PravinduG/sky130_op_amp/README.md

# sky130_ef_ip__template 

Designed by Pravindu Goonetilleke and Nilakna Warushavithana for the IEEE CASS–CEDA Analog IC Design Contest.

- [Documentation](docs/sky130_ef_ip__template.md)
- Characterization
  - [CACE](docs/sky130_op_amp_rcx.md)
  - [schematic](docs/sky130_op_amp_schematic.svg)
  - [layout](docs/sky130_op_amp_b.png)

## License and Information

[The Apache License, version 2.0](https://www.apache.org/licenses/LICENSE-2.0.txt).
