PravinduG/sky130_op_amp/documentation/OPAMP_REPORT.pdf

# Low-Power Single-Ended Operational Amplifier Design Using Sky130 PDK

Analog IC Student Design Contest ’25

1

st Nilakna Warushavithana
Dept. of Electronic and Telecommunication Engineering University of Moratuwa
Katubedda, Sri Lanka
nilaknawarushavithana@gmail.com

1

st Pravindu Goonetilleke
Dept. of Electronic and Telecommunication Engineering University of Moratuwa
Katubedda, Sri Lanka
pravindugoonetilleke@gmail.com

Abstract—This paper presents the design and implementation of a low-power, single-ended operational amplifier using the SkyWater 130 nm CMOS process design kit (SKY130 PDK). The amplifier is designed to function as a non-inverting unity-gain buffer for low-frequency analog signals in the 1-10 kHz range, operating with a supply voltage between 1.7 V and 1.9 V. The design targets a DC gain exceeding 60 dB, a gain-bandwidth product greater than 1 MHz, and phase margin above 60 degrees while maintaining quiescent current consumption below 100 . Complete schematic and post-layout simulations including DC, AC, transient, corner, and Monte Carlo analyses are presented. The final layout fits within the 140 µm × 80 µm area constraint with careful attention to matching and parasitic-aware design techniques.
Index Terms—operational amplifier, low-power, SKY130 PDK, analog IC design, unity-gain buffer, CMOS
I. INTRODUCTION

Low-power operational amplifiers are fundamental building blocks in modern analog and mixed-signal integrated circuits, finding applications in sensor interfaces, signal conditioning, data acquisition systems, and biomedical electronics. Hence, low-voltage, low-power operational amplifier designs are important.
This work presents the complete design flow of a single-ended operational amplifier implemented in the open-source SkyWater 130 nm CMOS process, from architecture selection through post-layout verification. The design targets operation as a unity-gain buffer for low-frequency signals while meeting specified power and area constraints.
The design methodology follows initial hand calculations, schematic-level optimization, extensive simulation verification, careful layout with matching techniques, and comprehensive post-layout validation.

II. DESIGN SPECIFICATIONS AND REQUIREMENTS

The target specifications for the operational amplifier design, as provided by the contest organizers, are listed in Table I.
Interface and power constraints were specified to include one analog supply (VDD), one ground (VSS), differential

TABLE I
TARGET DESIGN SPECIFICATIONS
Parameter | Specification
Technology Supply Voltage (VDD) Input Common-Mode Range Output Load (CL) Temperature Range Input Signal Amplitude Signal Frequency DC Gain (ADC ) Gain-Bandwidth Product (GBW) Phase Margin (PM) Quiescent Current Input Offset Voltage Slew Rate (SR) Disable Current Layout Area | 130 nm CMOS (SKY130) 1.7 - 1.9 V VDD/2 ± 0.2 V 25pF (capacitive) 20 - 50°C < 0.4 Vpp 1 - 10 kHz ≥ 60 dB ≥ 1 MHz > 60 < 100µA < 3 mV > 1 V/µs < 2 nA ≤ 140µm × 80µm

inputs (Vp, Vn), single-ended output (Vout), bias current input (Ibias = 5µA), and digital enable signal (EN). Disable mode should limit the supply current to 2 nA and output node current to 1nA.

III. CIRCUIT ARCHITECTURE AND DESIGN

A. Topology Selection
A two-stage operational amplifier topology was selected for this design because it allows a moderate gain-bandwidth product, an area-efficient layout because of only two stages, low power consumption with proper biasing, and stabile frequency response due to Miller compensation.
The first stage is a differential pair with PMOS current mirror active load providing high gain, while the second stage is a common-source amplifier providing additional gain and low output impedance. Miller compensation capacitor connects the output to the input of the second stage to ensure stability.
B. First Stage Design
The input differential pair employs NMOS transistors (M1-M2) to maximize input common-mode range around VDD/2.

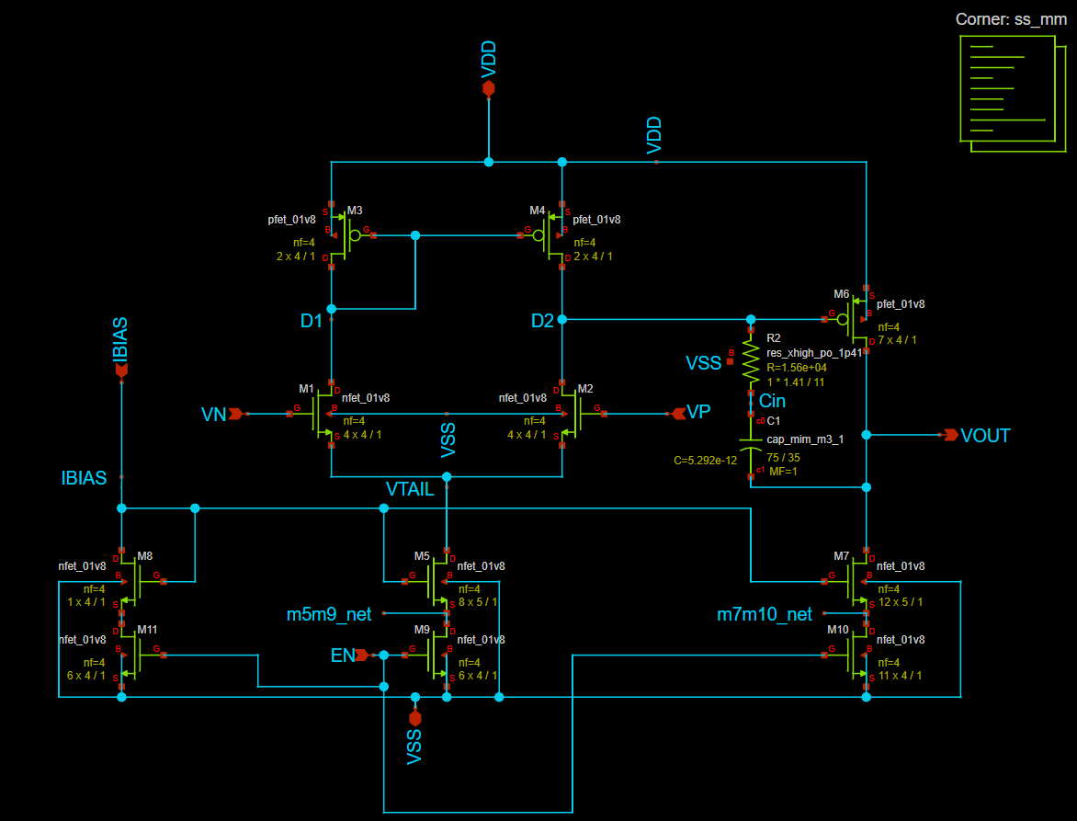
[picture p3: figure]

Fig. 1. Schematic of the design

The active load consists of a PMOS current mirror (M3-M4) providing high differential gain. The tail current source (M5) is biased from the mirrored Ibias current and switched (M9) by the enable signal.
Design parameters:
- Input transistor width: W1 = W2 = 16 µm
- Input transistor length: L1 = L2 = 1 µm
- Active load transistor width: W3 = W4 = 8 µm
- Active load transistor length: L3 = L4 = 1 µm
- Tail current source transistor width: W5 = 40 µm
- Tail current source transistor length: L5 = 1 µm
C. Second Stage Design

The output stage uses a common-source PMOS amplifier (M6) with NMOS current source load (M7), switched by NMOS (M10) by the enable signal. This stage provides additional voltage gain and drives the 25pF output load. Design parameters:

- Output transistor width: W6 = 28 µm
- Output transistor length: L6 = 1 µm
- Current source transistor width: W7 = 60 µm
- Current source transistor length: L7 = 1 µm
D. Frequency Compensation

Miller compensation is implemented using a capacitor C1 connected between the output and the input of the second stage. A resistor R1 in series with C1 eliminates the righthalf-plane zero created by Miller compensation.
Design parameters:
- Compensation capacitor: C1 = 5.292 pF
- Nulling resistor: R1 = 15.6 kΩ
- Unity-gain frequency: fu ≈ 10 MHz
E. Bias Circuit

The external 5 µA bias current is mirrored through a cascode current mirror structure (M8, M5, M7)to generate all internal bias currents. Current ratios are set to achieve desired bias levels while maintaining the total quiescent current below 100 µA.
Design parameters:
- Mirroring transistor width: W8 = 4 µm
- Mirroring transistor length: L8 = 1 µm
F. Enable/Disable Functionality

The enable signal controls current supply in the circuit and limits the supply current to 2 nA and output node current to 1nA in disable mode. The Enable signal is switched via transistors at each stage (M9 and M10) and bias (M11). Design parameters:
- Switching transistor (Stage 1) width: W9 = 24 µm
- Switching transistor (Stage 1) length: L9 = 1 µm
- Switching transistor (Stage 2) width: W10 = 44 µm
- Switching transistor (Stage 2) length: L10 = 1 µm
- Switching transistor (Bias) width: W11 = 24 µm
- Switching transistor (Bias) length: L11 = 1 µm

IV. SCHEMATIC-LEVEL SIMULATION RESULTS

A. DC Analysis

DC analysis was performed at nominal conditions (VDD = 1.8 V, T = 27°C, TT corner) to verify proper biasing of all transistors. All MOSFETs operate in saturation region with adequate overdrive voltages.
Key operating point results:
- Total quiescent current: IQ = 113 µA (enabled), 138 pA (disabled)
- Input common-mode voltage: VCM = 0.9 V
The following parameters were obtained with the op-amp configured as a unity gain non-inverting buffer:
- Input Offset voltage: VIN,OF F SET ≈ 0 mV
- DC Operating point: VOUT ,DC ≈ 0 mV

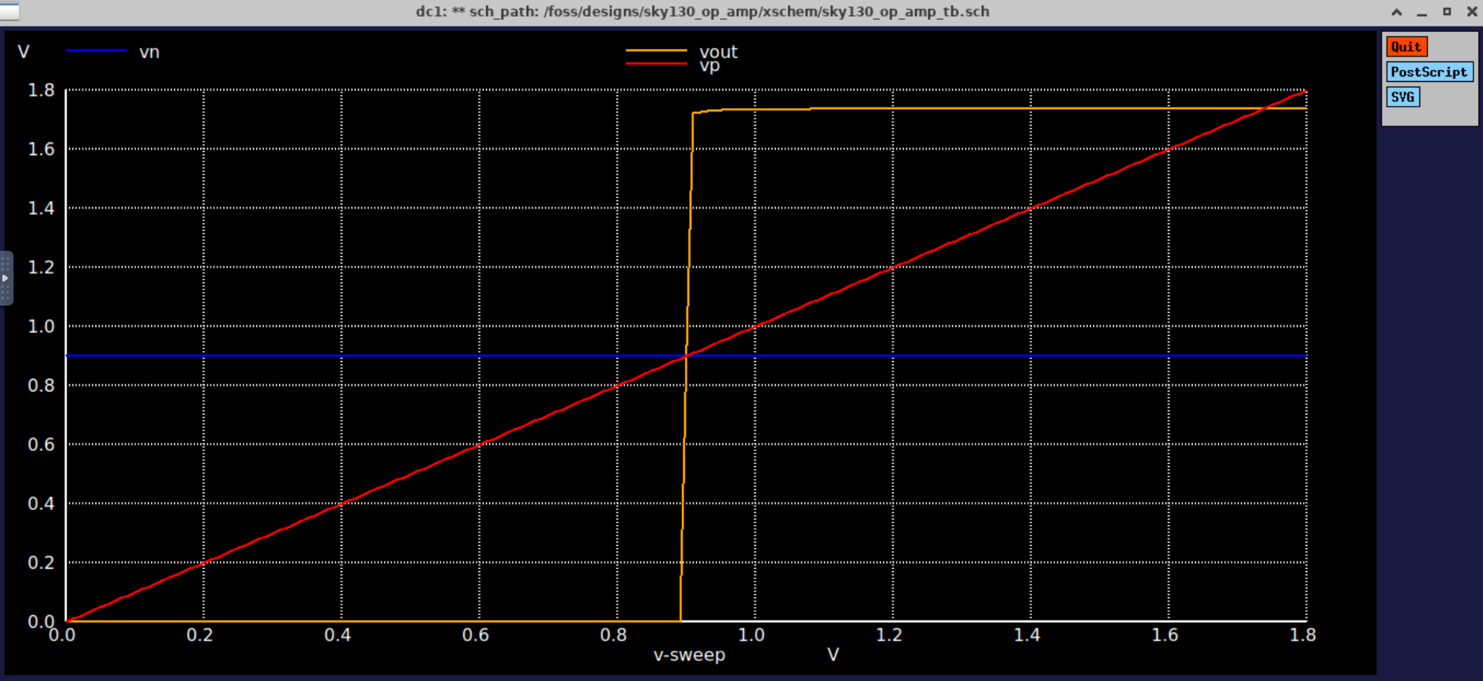
[picture p4: figure]

Fig. 2. DC operating point graph at TT corner.

Fig. 3. Input offset and DC operating point

B. DC Gain

DC sweep analysis determined the DC gain. Results:
- Open-loop DC gain: ADC ≈ 72.38 dB
C. AC/Frequency Analysis

Small-signal AC analysis was performed in open-loop configuration to extract frequency-domain characteristics.

TABLE II
AC ANALYSIS RESULTS AT NOMINAL CONDITIONS (TT CORNER)
Parameter | Result | Spec
DC Gain GBW Phase Margin Gain Margin | 72.38 dB 12.234 MHz 98° > 20dB | ≥ 60 dB ≥ 1 MHz > 60° -

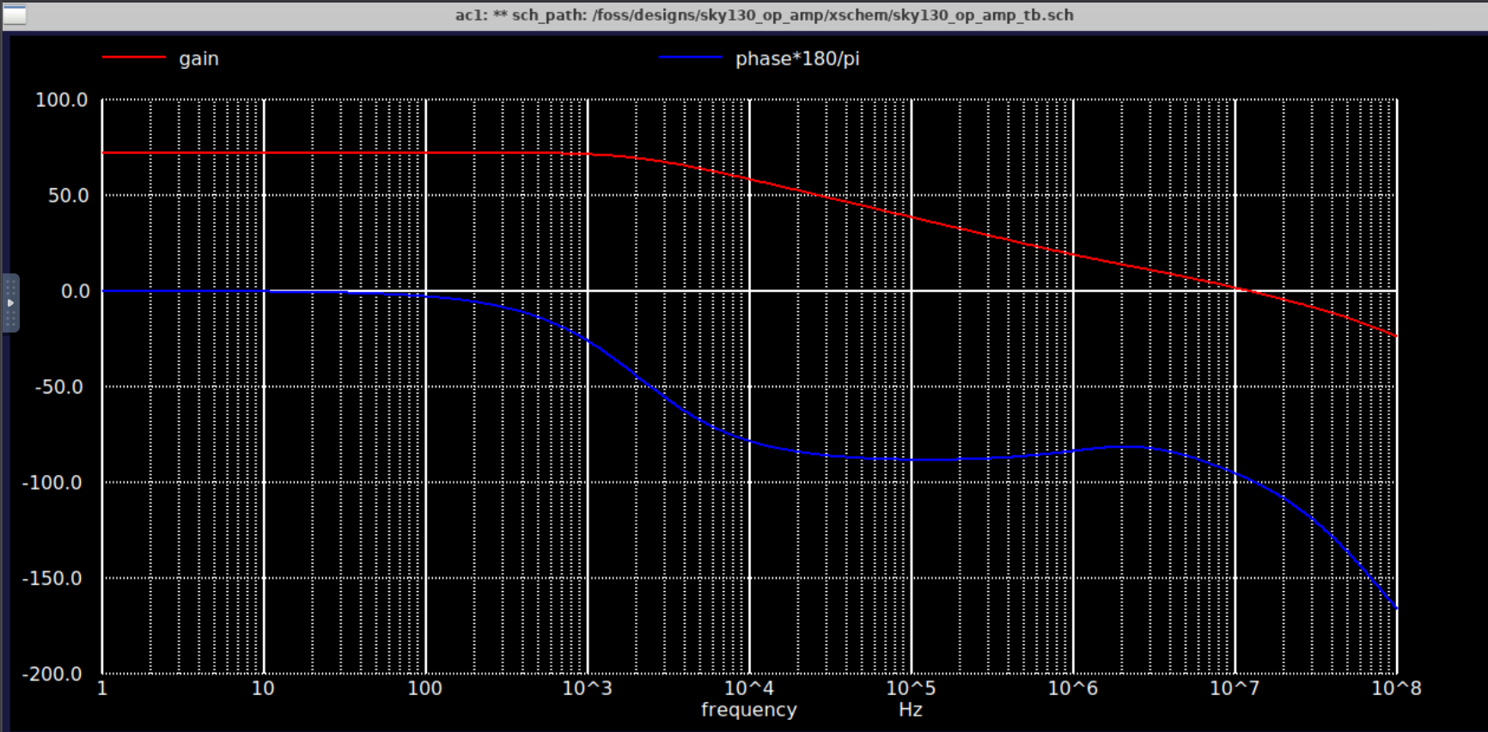
[picture p5: figure]

Fig. 4. AC magnitude and phase plot at TT corner.

D. Transient Analysis

Transient simulations verified time-domain performance.
- Output voltage swing: 0 V to 1.7 V

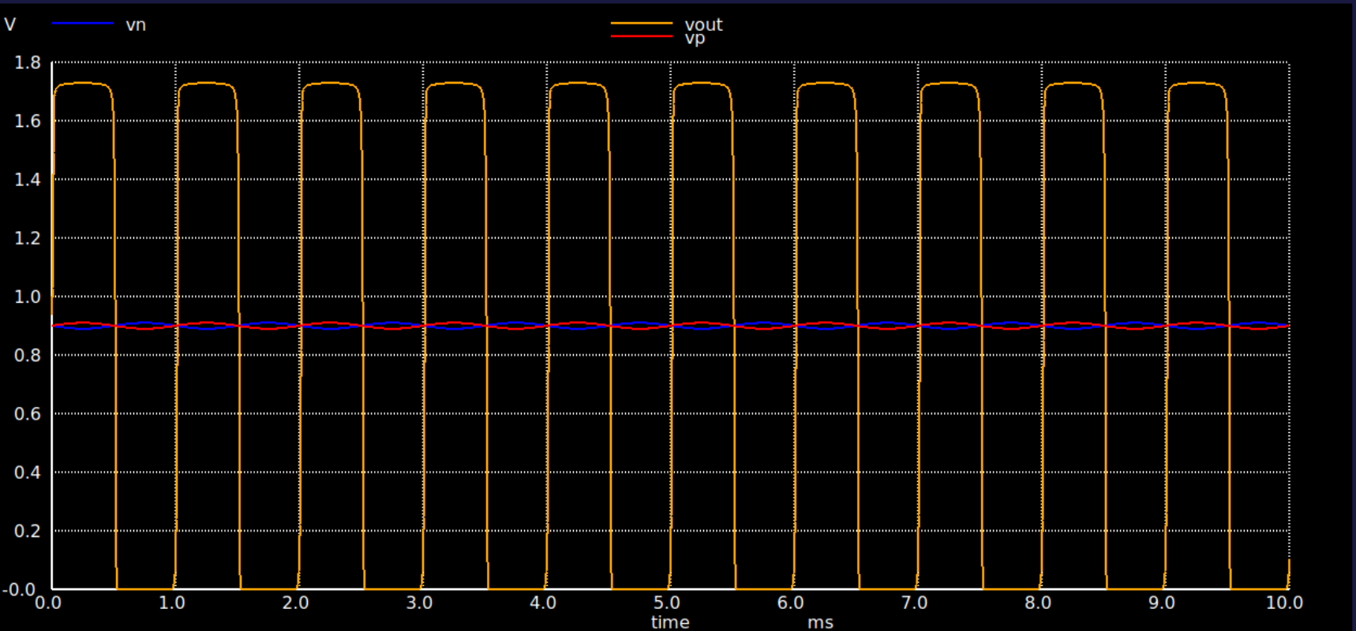
[picture p6: figure]

Fig. 5. Transient output response 0 V to 1.7 V.

- Sinusoidal Input 10µV

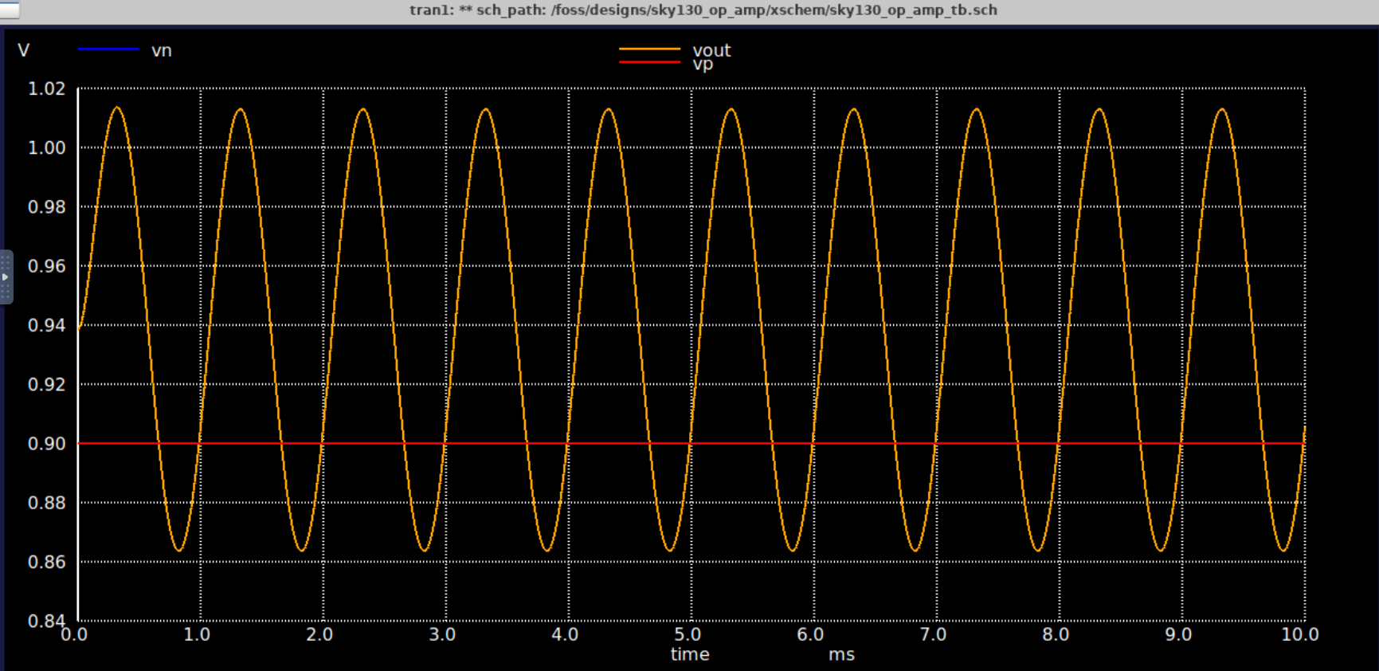
[picture p7: figure]

Fig. 6. Transient response for 10 µV input at TT corner.

E. Closed-Loop and Open-Loop Slew Rate Analysis

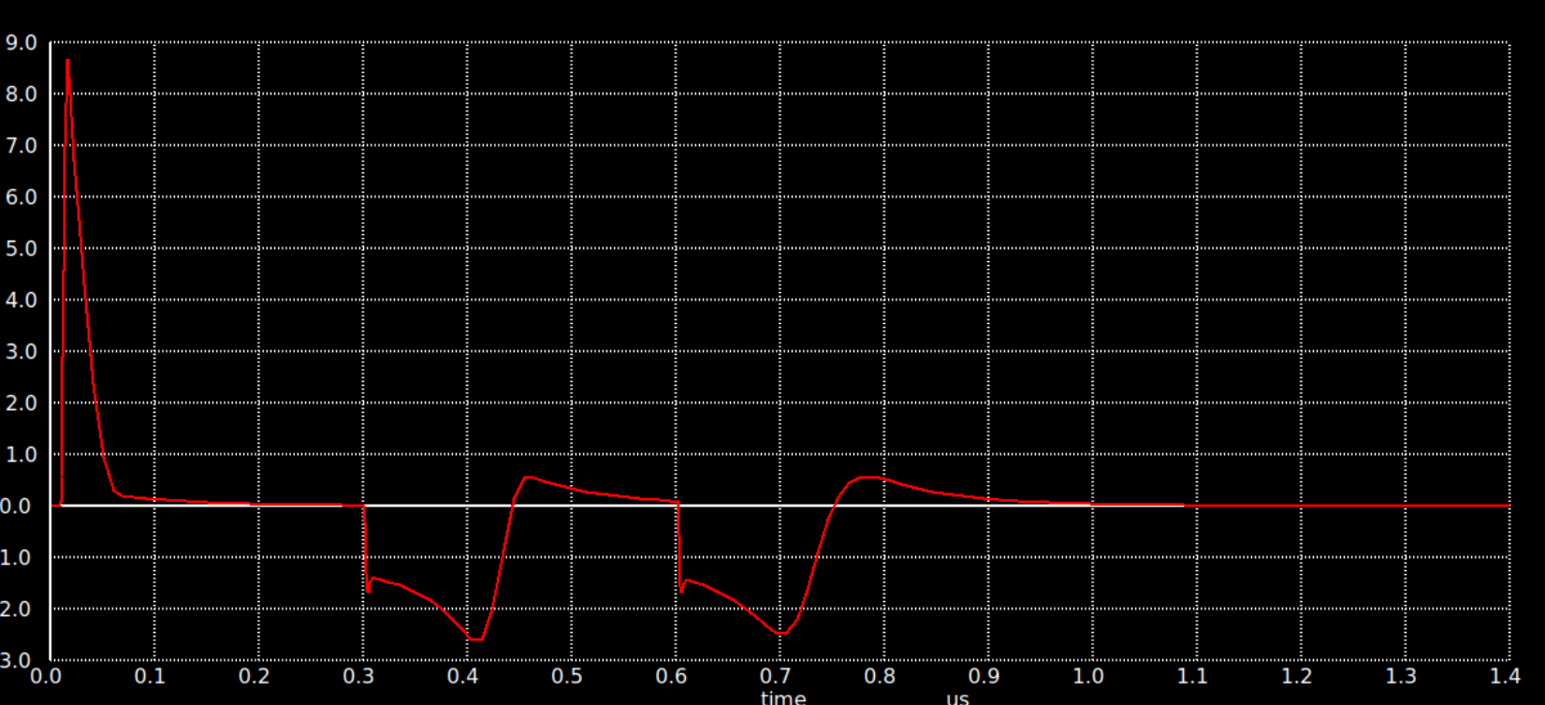
[picture p8: figure]

Fig. 7. Closed-loop positive and negative slew rate values at TT corner.

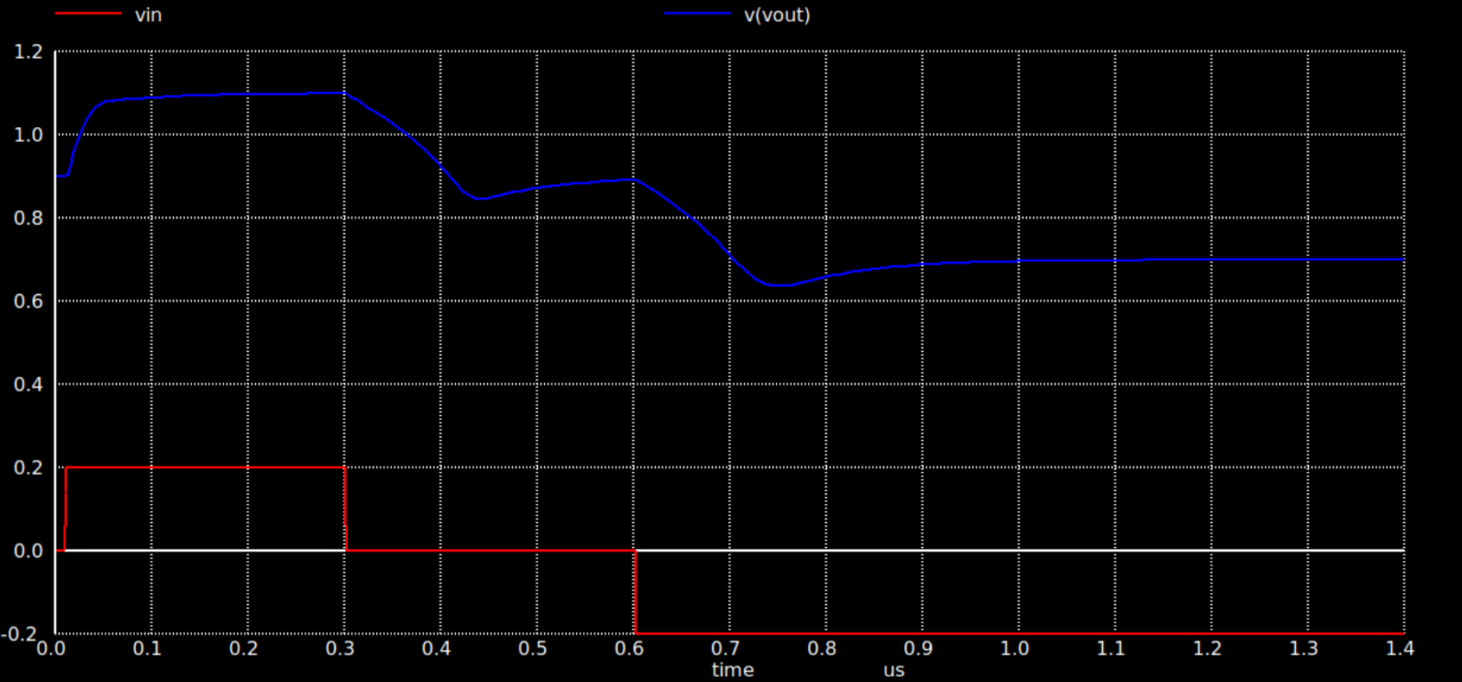
[picture p9: figure]

Fig. 8. Transient closed-loop slew rate response (1.1 V pos, 0.7 V neg) at TT corner.

Fig. 9. Maximum and minimum closed-loop slew rates at TT corner.

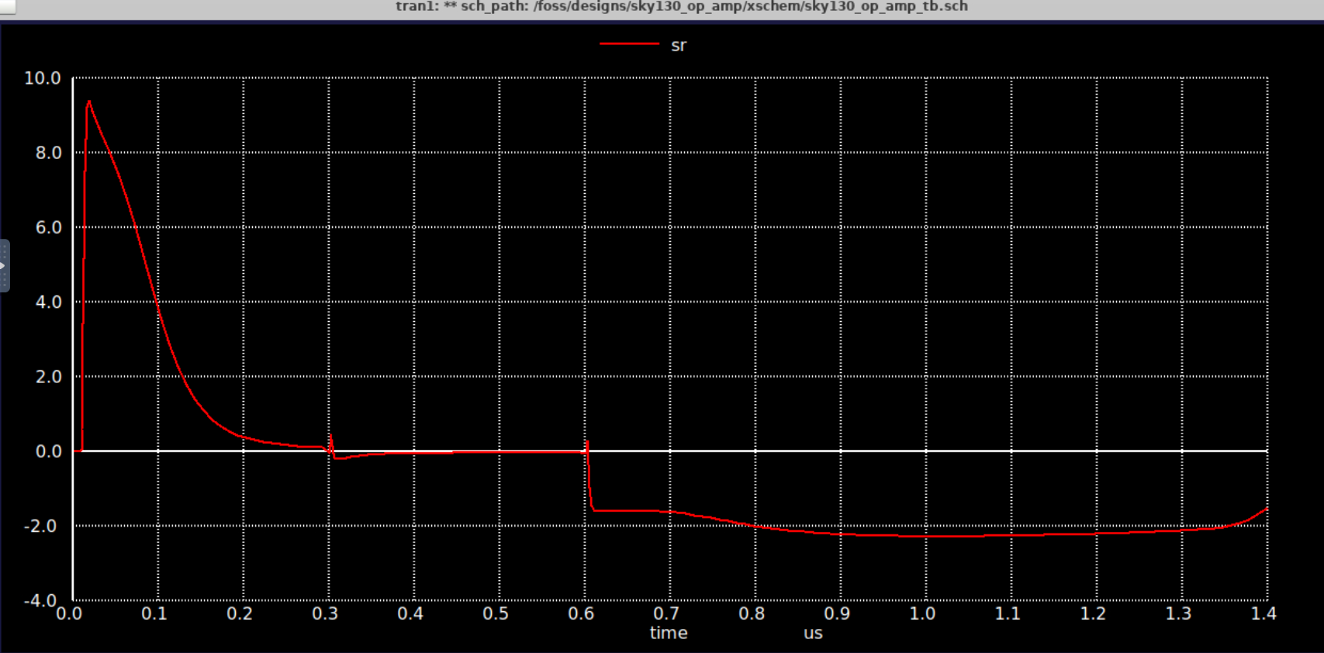
[picture p10: figure]

Fig. 10. Open-loop positive and negative slew rate values at TT corner.

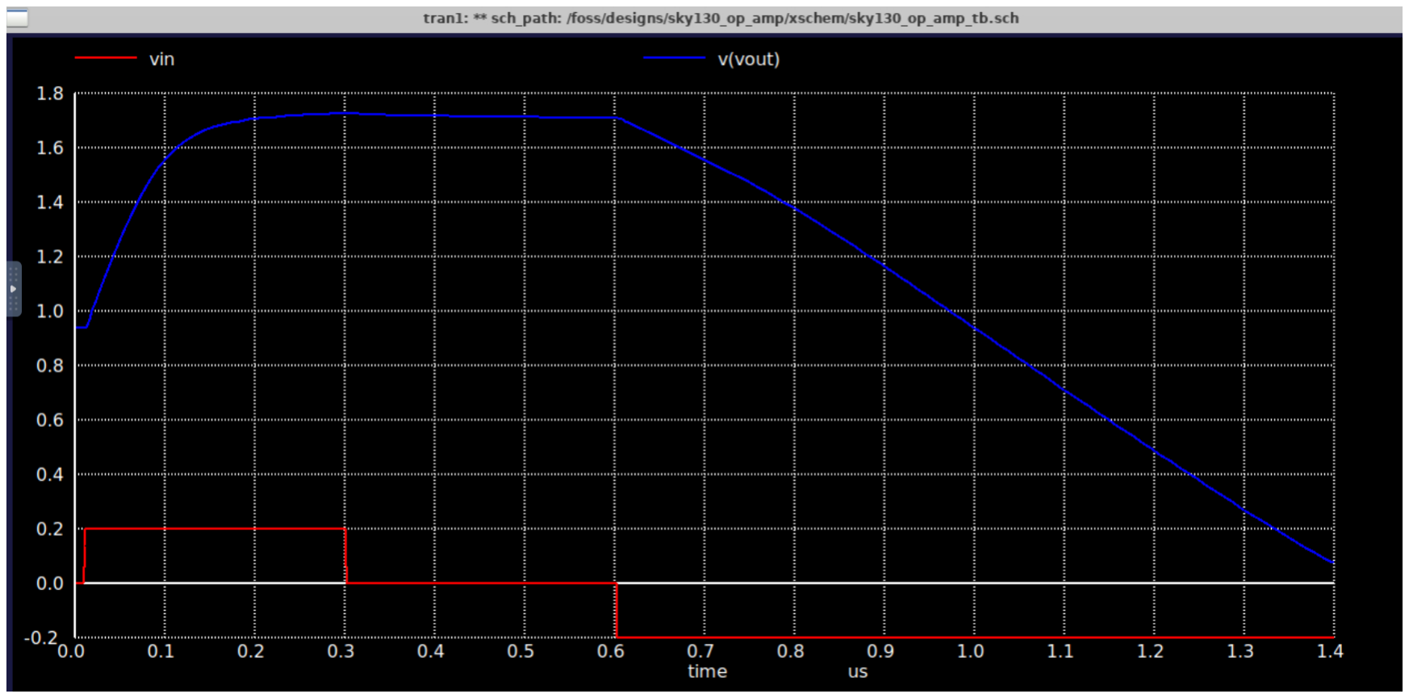
[picture p11: figure]

Fig. 11. Transient open-loop slew rate response (1.1 V pos, 0.7 V neg) at TT corner.

Fig. 12. Maximum and minimum open-loop slew rates at TT corner.

TABLE III
SLEW-RATE ANALYSIS RESULTS (TT CORNER)
Parameter | Result | Spec
Positive Slew Rate (min) Negative Slew Rate (min) | 8.66 V /µs -2.27 V /µs | 1 V /µs -1 V /µs
F. Corner Analysis
Process corner simulations were performed across the VDD range 1.7V-1.9V, and across the temperature range 20-50°C.

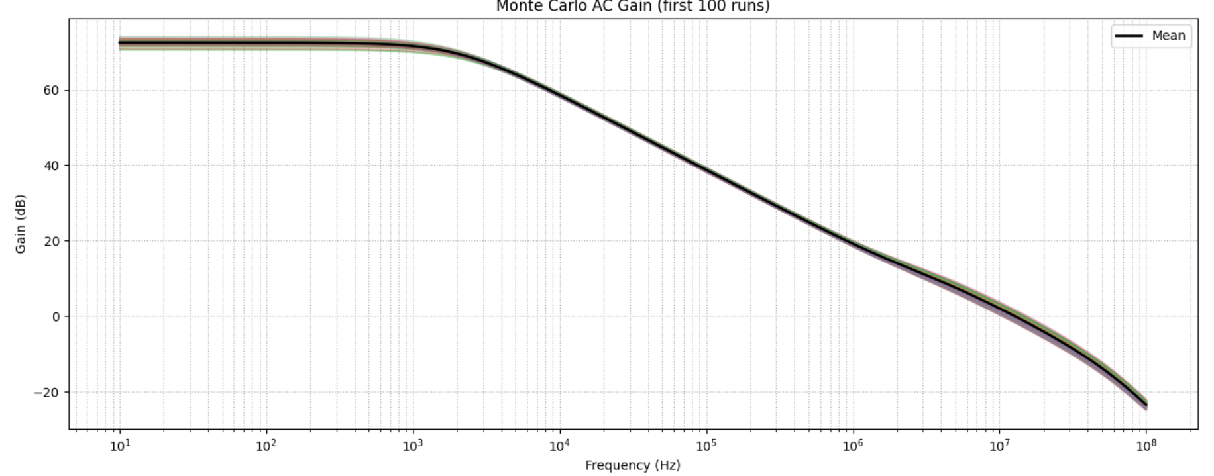
[picture p12: figure]

Fig. 13. Monte-Carlo simulation of gain at TT corner

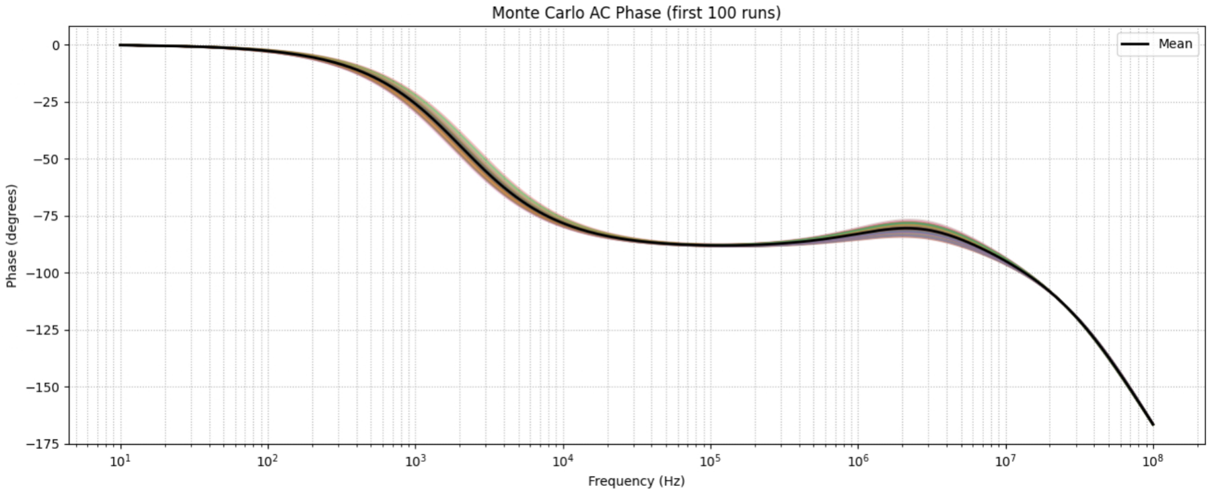
[picture p13: figure]

Fig. 14. Monte-Carlo simulation of phase at TT corner

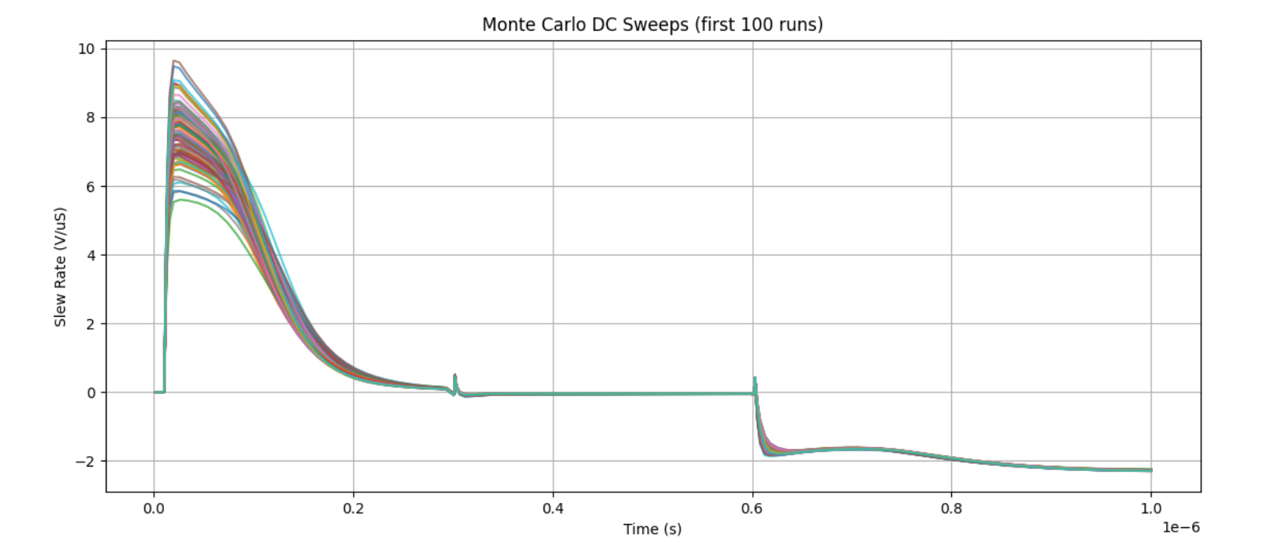
[picture p14: figure]

Fig. 15. Monte-Carlo simulation of positive and negative slew rate at TT corner

The monte-carlo simulations reveal that the design holds its parameters across VDD and temperature variations for the TT corner.

G. Disable Mode Verification
With EN = 0, the circuit enters low-power mode:
- Supply current: IDD,disable = 138 pA
V. PHYSICAL LAYOUT DESIGN
A. Layout Strategy
The layout was designed with careful consideration of matching, symmetry, parasitic effects, and area constraints. The floorplan organizes the circuit into functional blocks, and common centroid designs were employed for differential pair (M1-M2), pmos active load (M3-M4), tail current source unit (M5-M9), bias unit (M8-M11), and output current source (M7-M10), for the above considerations [fig. 16].

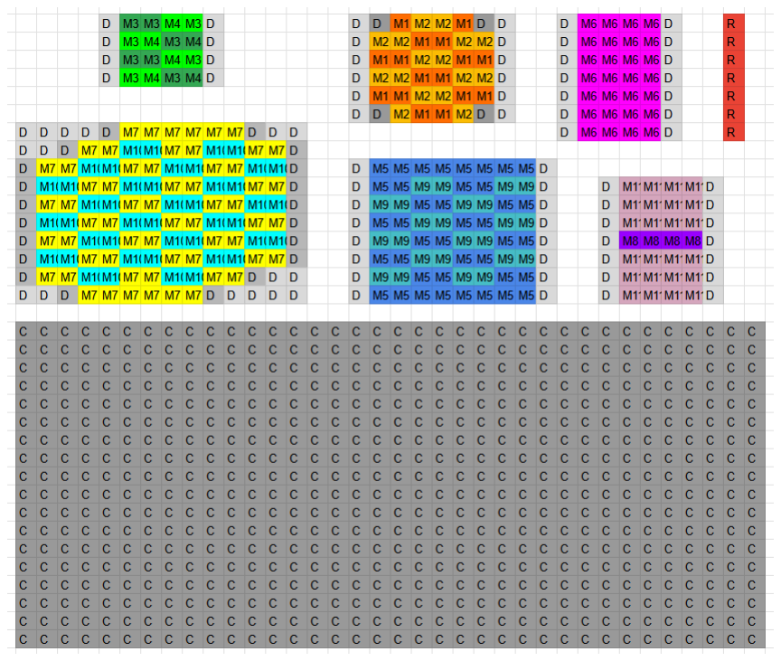
[picture p15: figure]

Fig. 16. Floor plan of the layout

B. Device Matching Techniques

The operational amplifier requires identical performance in several matching devices, like differential pair and current mirrors, and the following techniques were employed for better matching of such devices and overall circuit.
- Common centroid layout was used for matching pairs like the differential pair (M1-M2) and current mirror pairs (M3-M4).
- Common centroid was used for the biasing network with cascoded current mirror and enable switches, since the devices should be similar for the mirror load and its switch.
- The whole biasing network is not incorporated to a single centroid layout because that would cause a large area of about 200 transistor devices, which may cause large heat generation and different outcomes than expected of centroids.
So, each mirroring transistor and its enabling transistor are employed in separate centroid layouts: M8-M11, M5-M9, and M7-M10.
- Guard rings are added around each unit to isolate their functionality and avoid unwanted parasitic effects from nearby units.
- Dummy transistor devices are added at terminals to preserve uniform characteristics across each device in use.
- Identical orientation is used for all devices and matched pairs to ensure process variations would affect in a similar manner.
C. Layer Stack

Layers from nwell to metal4 in SKY130 technology are utilized in the layout, where routing utilizes Metal1 to Metal3, and the capacitor uses MiMcap and Metal4 layers.

D. Design Rule Compliance
The layout passes all DRC (Design Rule Check) rules specified in the SKY130 PDK with zero violations. LVS (Layout Versus Schematic) verification confirms full netlist matching.
E. Final Layout
The final layout fits within 88 µm × 76 µm area and has connections to specified I/O pins: VP, VN, VDD, VOUT, EN, IBIAS, and VSS (top left → bottom left → top right → bottom right) as shown in fig.17.


Fig. 17. Final Layout of the OpAmp

VI. POST-LAYOUT SIMULATION RESULTS

A. Parasitic Extraction
RC parasitic extraction was performed using the standard parasitic extraction tools for SKY130 PDK.
B. Post-Layout Performance
This section compares schematic and post-layout performance.
Note: DC Gain, GBW, Phase margin, and Layout Area were obtained from the generated CACE datasheet. Slew Rate, Quiescent current, Input offset, and Disable current were obtained using post layout simulations done on xschem.
1) CACE Summary: CACE summary reports for the sky130_op_amp design including schematic and post-layout verification results can be found here: CACE Summary. (https://github.com/PravinduG/sky130_op_amp/blob/main/docs/sky130_op_amp_rcx.md) The following variations were made:
- VDD : 1.7V, 1.8V, 1.9V
- Corner: TT, FF, SS, FS, SF
- Temperature: 20°C, 27° C, 50°C

TABLE IV
POST-LAYOUT SIMULATIONS BASED ON PEX, XSCHEM
Parameter | Achieved | Target
Quiescent Current Slew Rate Input Offset Disable Current | 109.8µA 1.2V /µs 0.0265 mV 194.5 pA | < 100µA > 1 V /µs < 3 mV < 2 nA
2) Post-Layout Simulations on xschem: All specifications are met across corners, VDD variations, and temperature variations, with layout parasitics included (IV.
C. Performance Summary
Table V presents the final performance achieved compared to target specifications:

TABLE V
FINAL PERFORMANCE SUMMARY
Parameter | Achieved | Target | Status
DC Gain GBW Phase Margin Quiescent Current Slew Rate Input Offset Disable Current Width Height Area | 71.373 dB 10.004 MHz 82.275° 109µA 1.2V /µs 0.0265 mV 194.5 pA 88.275µm 75.775µm 6689.038µm² | ≥ 60 dB ≥ 1 MHz > 60 < 100µA > 1 V /µs < 3 mV < 2 nA 140µm 80µm < 11200µm² | Pass Pass Pass Fail Pass Pass Pass Pass Pass Pass

VII. DESIGN TRADE-OFFS AND FUTURE IMPROVEMENTS

A. Trade-offs
During the process, a tradeoff between Gain, Slew Rate (specifically the negative slew rate), and Quiescent current was made. We were only able to achieve one of the following combinations at a time:
- Meeting gain and quiescent current targets
- Meeting gain and (negative) slew rate targets
Since the slew rate target significantly fell behind during corner evaluations, we opted to go for a slightly larger Quiescent current. Due to time constraints, we were unable to come up with a solution that met all 3 targets.
B. Future Improvements
In the future, we plan to find a solution to the trade-off mentioned above.

VIII. CONCLUSION
This work presented a complete design of a low-power single-ended operational amplifier in SKY130 130 nm CMOS technology, meeting the requirements of the Analog IC Student Design Contest ’25. The two-stage Miller-compensated topology achieves 71 dB DC gain, 10 MHz GBW, 82° phase margin, and consumes 109 µA quiescent current, all within a 88 µm × 76 µm layout area.
Extensive simulations, including DC, AC, transient, corner, and Monte Carlo, ensure robust performance across variations.

Post-layout simulations with extracted parasitics confirm that all specifications are met with adequate margins.

ACKNOWLEDGMENT
The authors would like to thank the organizers of the Analog IC Student Design Contest ’25 and the Tiny Tapeout initiative for providing this opportunity to work with open-source PDKs. We also acknowledge the support of the Department of Electronic and Telecommunication Engineering, University of Moratuwa.

REFERENCES

[1] B. Razavi, Design of Analog CMOS Integrated Circuits, 2nd ed. New York: McGraw-Hill, 2017.
[2] SkyWater Technology Foundry, “SKY130 Process Design Kit Documentation,” [Online]. Available: https://skywater-pdk.readthedocs.io/
