PravinduG/sky130_op_amp/documentation/OPAMP_PPT.pdf

## Low-Power Single-Ended Operational Amplifier Design Using Sky130 PDK

Analog IC Student Design Contest ’25

Nilakna Warushavithana Pravindu Goonetilleke

Dept. of Electronic and Telecommunication Engineering University of Moratuwa, Sri Lanka

October 26, 2025

N. Warushavithana, P. Goonetilleke (UoM) | Low-Power OpAmp Design | October 26, 2025 | 1 / 21

## Design Specifications

Parameter | Specification
Technology | SKY130 130 nm CMOS
Supply Voltage | 1.7 - 1.9 V
Input CM Range | VDD/2 ± 0.2 V
Output Load | 25 pF (Capacitive)
Temperature Range | 20 - 50 ◦C
Input Signal Amplitude | ≤ 0.4 Vpp
DC Gain | ≥ 60 dB
GBW | ≥ 1 MHz
Phase Margin | > 60◦
Quiescent Current | < 100µA
Input Offset | < 3 mV
Slew Rate | > 1 V / µs
Disable Current | < 2 nA Supply, < 1 nA Output
Bias Current | 5 µA
Layout Area | ≤ 140µm × 80µm
N. Warushavithana, P. Goonetilleke (UoM) | Low-Power OpAmp Design | October 26, 2025 | 2 / 21

## Circuit Architecture

Two-stage opamp topology:
Stage 1: NMOS differential pair with PMOS active load Stage 2: PMOS common-source amplifier
Miller compensation for stability
Enable/Disable functionality reduces current to nA range
N. Warushavithana, P. Goonetilleke (UoM) | Low-Power OpAmp Design | October 26, 2025 | 3 / 21

## Schematic


N. Warushavithana, P. Goonetilleke (UoM) | Low-Power OpAmp Design | October 26, 2025 | 4 / 21

## Schematic Highlights

Input differential pair for high gain
PMOS active load for first stage

Common-source output stage drives 25 pF load Miller compensation: C1 = 5.292 pF, R1 = 15.6 kΩ

Bias circuit provides stable currents

N. Warushavithana, P. Goonetilleke (UoM) | Low-Power OpAmp Design | October 26, 2025 | 5 / 21

## Schematic Level Simulation Results (Operating Point)

Total quiescent current: IQ = 113 µA (enabled), 138 pA (disabled)

Input common-mode voltage: VCM = 0.9 V
Input Offset voltage: VIN,OFFSET ≈ 0 mV
DC Operating point: VOUT,DC ≈ 0 mV

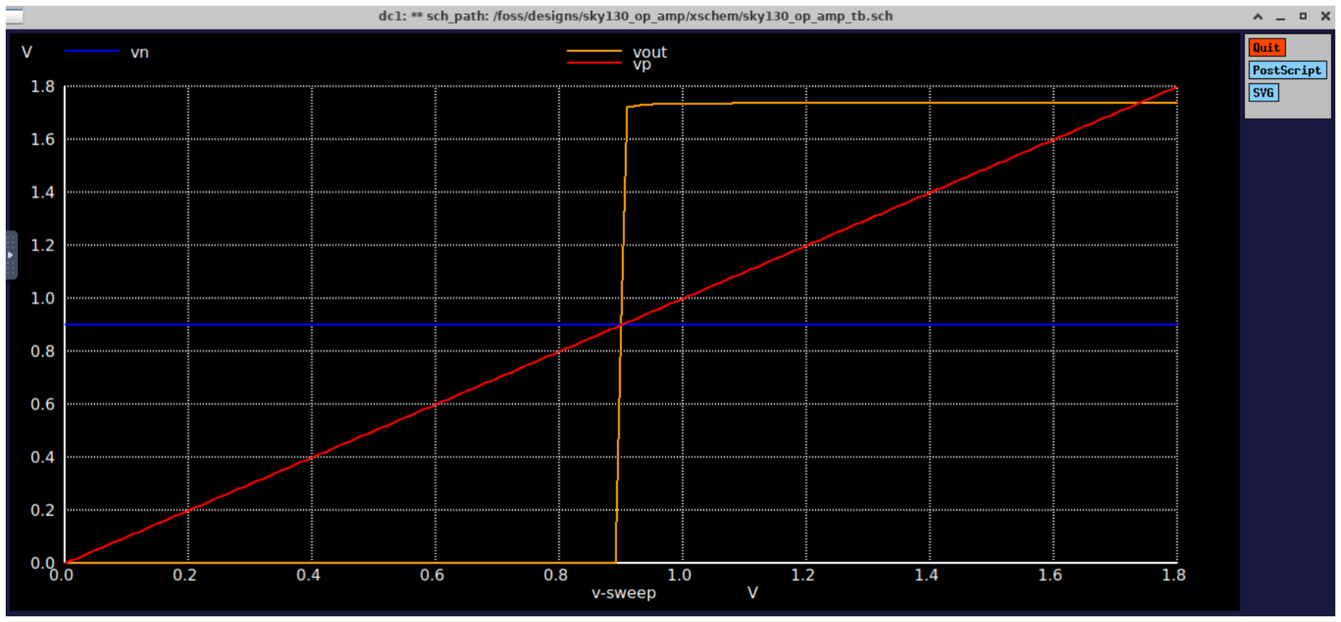
[picture p16: figure]

Figure: DC operating point graph at TT corner.

N. Warushavithana, P. Goonetilleke (UoM) | Low-Power OpAmp Design | October 26, 2025 | 6 / 21

## Schematic Level Simulation Results (Frequency)

Parameter | Achieved | Spec
DC Gain | 72.38 dB | ≥ 60 dB
GBW | 12.234 MHz | ≥ 1 MHz
Phase Margin | 98° | > 60
Slew Rate | 8.66 / -2.27 V/µs | > 1/ − 1 V/µs


Figure: Phase and Gain
N. Warushavithana, P. Goonetilleke (UoM) | Low-Power OpAmp Design | October 26, 2025 | 7 / 21

## Schematic Level Simulation Results (Transient Response)

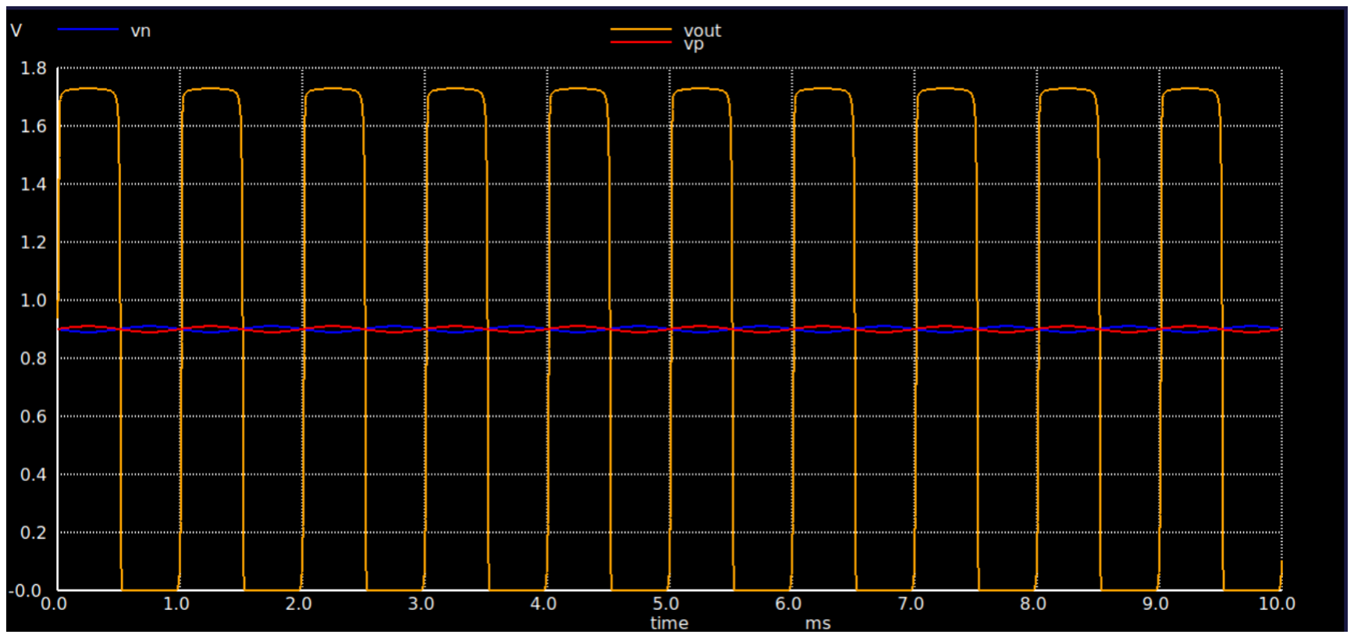
[picture p17: figure]

Output swing: 0 - 1.7 V
Sinusoidal response verified for low-level inputs (10 µV)

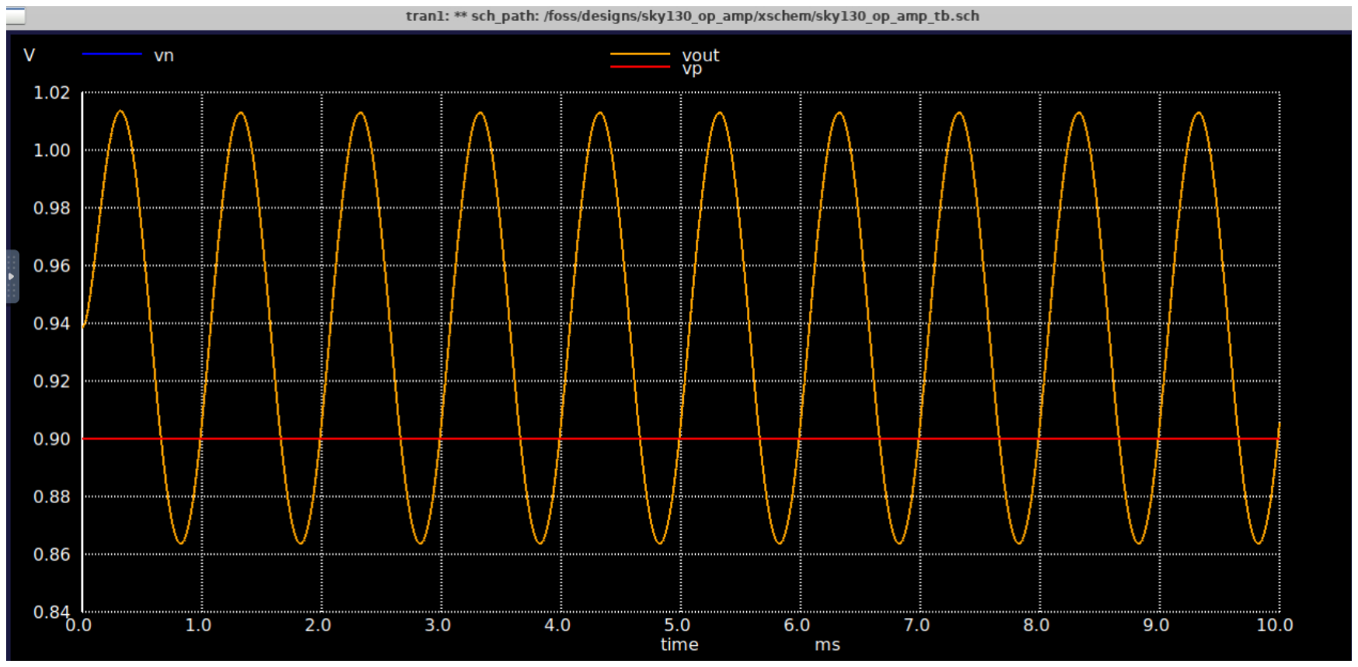
[picture p18: figure]

N. Warushavithana, P. Goonetilleke (UoM) | Low-Power OpAmp Design | October 26, 2025 | 8 / 21

## Schematic Level Simulation Results

Slew Rate

Table: Slew-Rate Analysis Results (TT corner)

Parameter | Result | Spec
Positive Slew Rate (min) Negative Slew Rate (min) | 8.66 V/µs -2.27 V/µs | 1 V/µs -1 V/µs

Disable Mode
With EN = 0, the circuit enters low-power mode: Supply current: IDD,disable = 138 pA
N. Warushavithana, P. Goonetilleke (UoM) | Low-Power OpAmp Design | October 26, 2025 | 9 / 21

## Process Corners - Monte Carlo Analysis


Figure: Monte-Carlo simulation of gain at TT corner

N. Warushavithana, P. Goonetilleke (UoM) | Low-Power OpAmp Design | October 26, 2025 | 10 / 21

## Process Corners - Monte Carlo Analysis

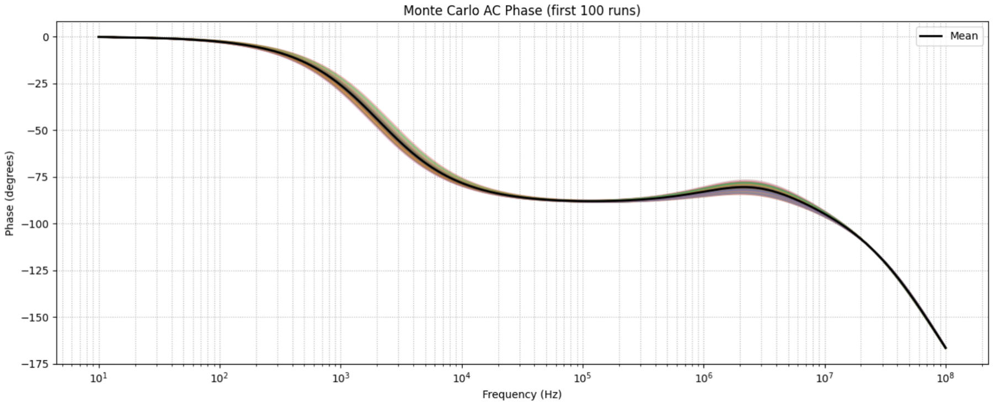
[picture p19: figure]

Figure: Monte-Carlo simulation of phase at TT corner

N. Warushavithana, P. Goonetilleke (UoM) | Low-Power OpAmp Design | October 26, 2025 | 11 / 21

## Process Corners - Monte Carlo Analysis


Figure: Monte-Carlo simulation of positive and negative slew rate at TT corner

N. Warushavithana, P. Goonetilleke (UoM) | Low-Power OpAmp Design | October 26, 2025 | 12 / 21

## Layout Design

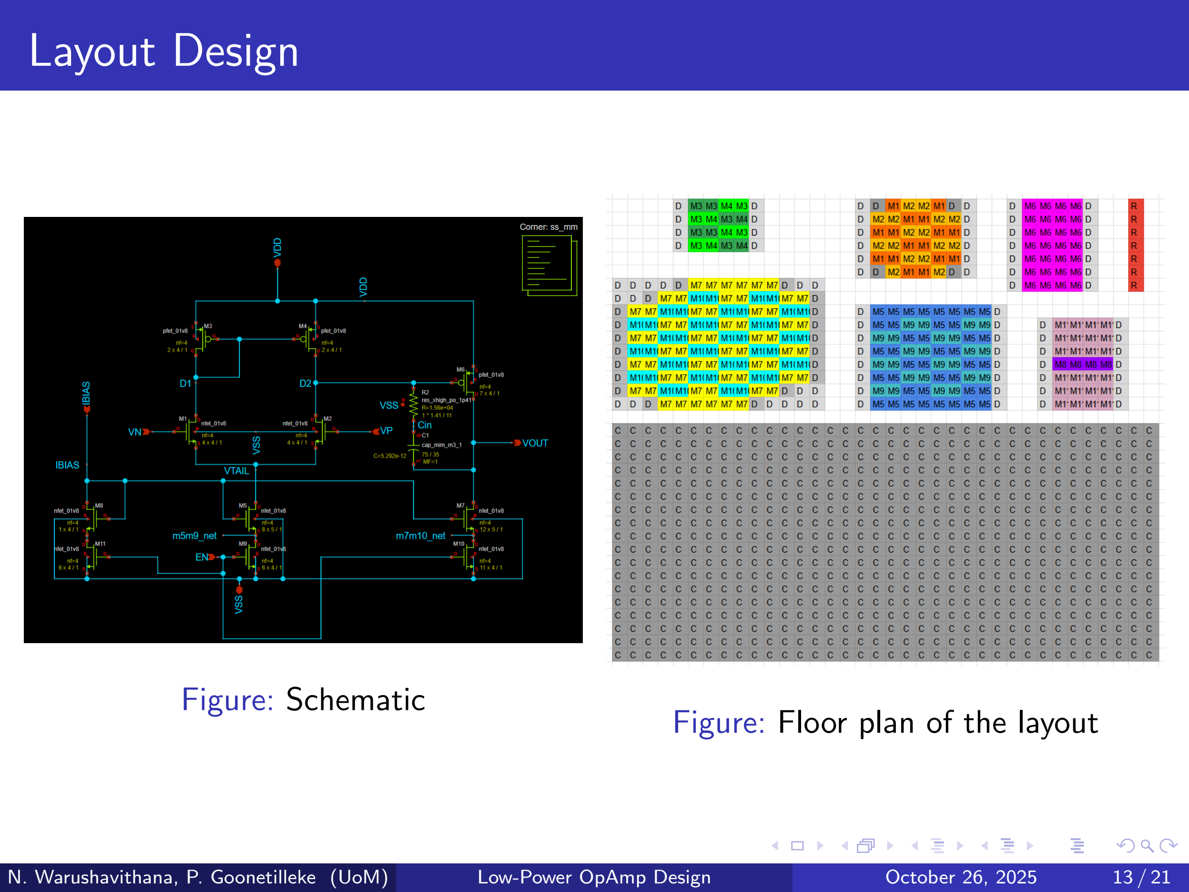
[picture p20: page 13]

Figure: Schematic
Figure: Floor plan of the layout
N. Warushavithana, P. Goonetilleke (UoM) | Low-Power OpAmp Design | October 26, 2025 | 13 / 21

## Layout Design


Figure: Final Layout of the OpAmp

N. Warushavithana, P. Goonetilleke (UoM) | Low-Power OpAmp Design | October 26, 2025 | 14 / 21

## Layout Design

Common centroid and symmetry for differential pair and current mirrors
Guard rings and dummy devices for parasitic minimization Total layout area: 88 × 76 µm²
N. Warushavithana, P. Goonetilleke (UoM) | Low-Power OpAmp Design | October 26, 2025 | 15 / 21

## Post-Layout Verification

Parasitic extraction (RC) using SKY130 tools Post-layout simulations:
DC, AC, transient verified
Specs mostly met; quiescent current slightly above target

Table: Post-Layout Simulations based on PEX, xschem

Parameter | Achieved | Target
Quiescent Current Slew Rate Input Offset Disable Current | 109.8µA 1.2V/µs 0.0265 mV 194.5 pA | < 100µA > 1 V/µs < 3 mV < 2 nA
N. Warushavithana, P. Goonetilleke (UoM) | Low-Power OpAmp Design | October 26, 2025 | 16 / 21

## CACE Simulation

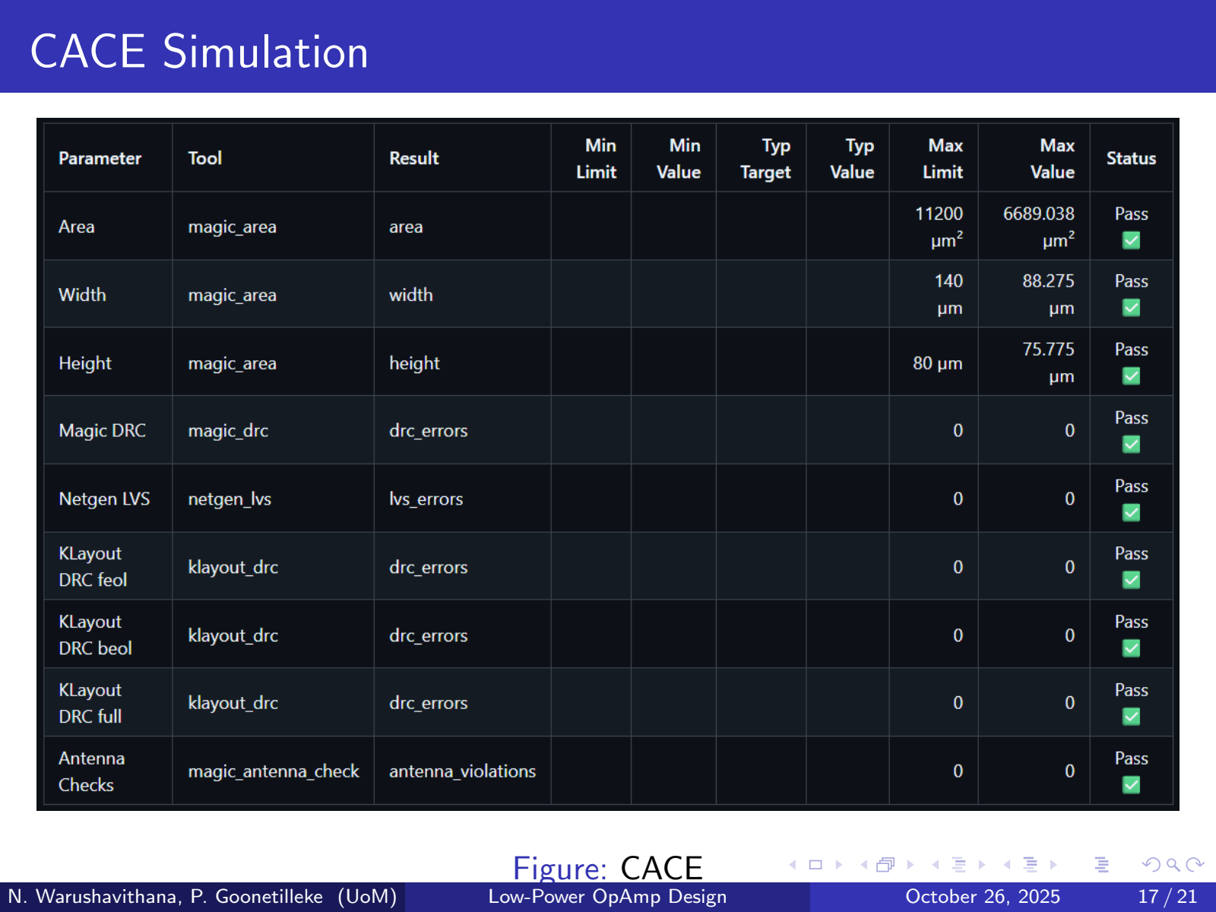
[picture p21: page 17]

Figure: CACE

N. Warushavithana, P. Goonetilleke (UoM) | Low-Power OpAmp Design | October 26, 2025 | 17 / 21

## Performance Summary

Parameter | Achieved | Target | Status
DC Gain | 71.373 dB | ≥ 60 dB | Pass
GBW | 10.004 MHz | ≥ 1 MHz | Pass
Phase Margin | 82.275° | > 60 | Pass
Quiescent Current | 109µA | < 100µA | Fail
Slew Rate | 1.2V/µs | > 1 V/µs | Pass
Input Offset | 0.0265 mV | < 3 mV | Pass
Disable Current | 194.5 pA | < 2 nA | Pass
Width | 88.275µm | 140µm | Pass
Height | 75.775µm | 80µm | Pass
Area | 6689.038µm² | < 11200µm² | Pass
N. Warushavithana, P. Goonetilleke (UoM) | Low-Power OpAmp Design | October 26, 2025 | 18 / 21

## Design Trade-offs

Trade-off between quiescent current and negative slew rate

Achieved slightly higher quiescent current to meet slew rate target Future improvement: optimize negative slew rate without increasing power

N. Warushavithana, P. Goonetilleke (UoM) | Low-Power OpAmp Design | October 26, 2025 | 19 / 21

## Conclusion

Designed and implemented a low-power, two-stage opamp in SKY130 PDK
Specs met for DC gain, GBW, phase margin, slew rate, area, and disable current
Post-layout verification confirms robustness across corners and parasitic effects
Demonstrates open-source analog IC design flow from schematic to layout
N. Warushavithana, P. Goonetilleke (UoM) | Low-Power OpAmp Design | October 26, 2025 | 20 / 21

## Acknowledgment

Thanks to Analog IC Student Design Contest ’25 and Tiny Tapeout initiative
Support from Dept. of Electronic and Telecommunication Engineering, University of Moratuwa
N. Warushavithana, P. Goonetilleke (UoM) | Low-Power OpAmp Design | October 26, 2025 | 21 / 21
