PravinduG/sky130_op_amp/docs/sky130_ef_ip__template_rcx.md

# CACE Summary for sky130_ef_ip__template

**netlist source**: rcx

| Parameter | Tool | Result | Min Limit  |  Min Value | Typ Target |  Typ Value | Max Limit  |  Max Value |  Status  |
| :--- | :--- | :--- | ---: | ---: | ---: | ---: | ---: | ---: | :---: |
| Area | magic_area | area | | | | | 11200 µm² | 6689.038 µm² | Pass ✅ |
| Width | magic_area | width | | | | | 140 µm |  88.275 µm | Pass ✅ |
| Height | magic_area | height | | | | | 80 µm |  75.775 µm | Pass ✅ |
| Magic DRC | magic_drc | drc_errors | | | | | 0 | 0 | Pass ✅ |
| Netgen LVS | netgen_lvs | lvs_errors | | | | | 0 | 0 | Pass ✅ |
| KLayout DRC feol | klayout_drc | drc_errors | | | | | 0 | 0 | Pass ✅ |
| KLayout DRC beol | klayout_drc | drc_errors | | | | | 0 | 0 | Pass ✅ |
| KLayout DRC full | klayout_drc | drc_errors | | | | | 0 | 0 | Pass ✅ |
| Antenna Checks | magic_antenna_check  | antenna_violations | | | | | 0 | 0 | Pass ✅ |
