PravinduG/sky130_op_amp/docs/sky130_op_amp_rcx.md

# CACE Summary for sky130_op_amp

**netlist source**: rcx

| Parameter | Tool | Result | Min Limit  |  Min Value | Typ Target |  Typ Value | Max Limit  |  Max Value |  Status  |
| :--- | :--- | :--- | ---: | ---: | ---: | ---: | ---: | ---: | :---: |
| DC gain | ngspice | a0 | 60 dB |  65.616 dB | any |  71.373 dB | any |  73.096 dB | Pass ✅ |
| Unity Gain Frequency | ngspice | ugf | 1e6 Hz | 8470940.000 Hz | any | 10004000.000 Hz | any | 11573600.000 Hz | Pass ✅ |
| Phase Margin | ngspice | pm | 60 ° | 80.959 ° | any | 82.275 ° | any | 83.749 ° | Pass ✅ |
| Area | magic_area | area | | | | | 9600 µm² | 6689.038 µm² | Pass ✅ |
| Width | magic_area | width | | | | | any |  88.275 µm | Pass ✅ |
| Height | magic_area | height | | | | | any |  75.775 µm | Pass ✅ |
| Magic DRC | magic_drc | drc_errors | | | | | 0 | 0 | Pass ✅ |
| Netgen LVS | netgen_lvs | lvs_errors | | | | | 0 | 0 | Pass ✅ |
| KLayout DRC feol | klayout_drc | drc_errors | | | | | 0 | 0 | Pass ✅ |
| KLayout DRC beol | klayout_drc | drc_errors | | | | | 0 | 0 | Pass ✅ |
| KLayout DRC full | klayout_drc | drc_errors | | | | | 0 | 0 | Pass ✅ |
| Antenna Checks | magic_antenna_check  | antenna_violations | | | | | 0 | 0 | Pass ✅ |

## Plots

## gain_vs_temperature

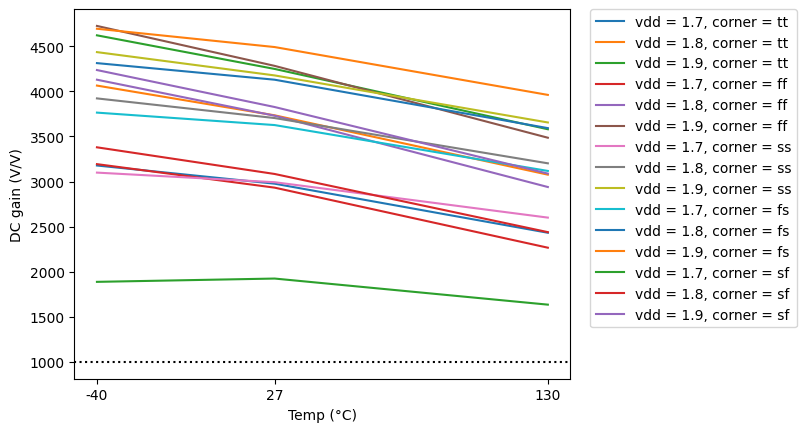
[picture p22: docs/sky130_op_amp/rcx/gain_vs_temperature.png]
gain_vs_temperature


## phase_margin_vs_corner

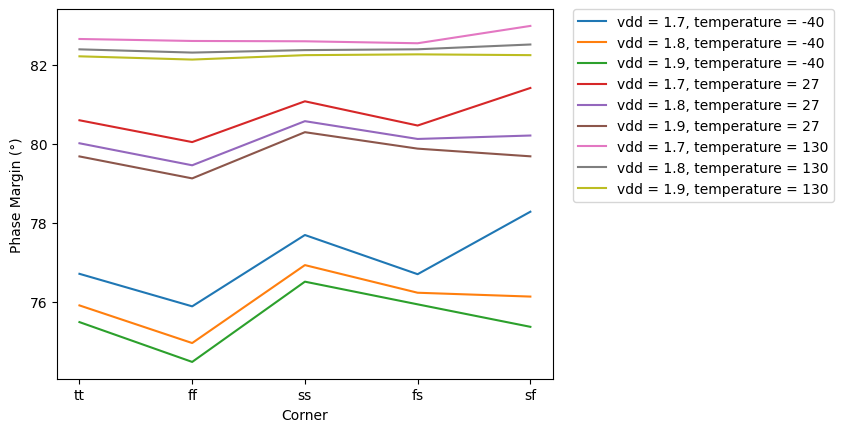
[picture p23: docs/sky130_op_amp/rcx/phase_margin_vs_corner.png]
phase_margin_vs_corner
