PravinduG/sky130_op_amp/images/post_layout_sims/pl_mc_sr_fs.png

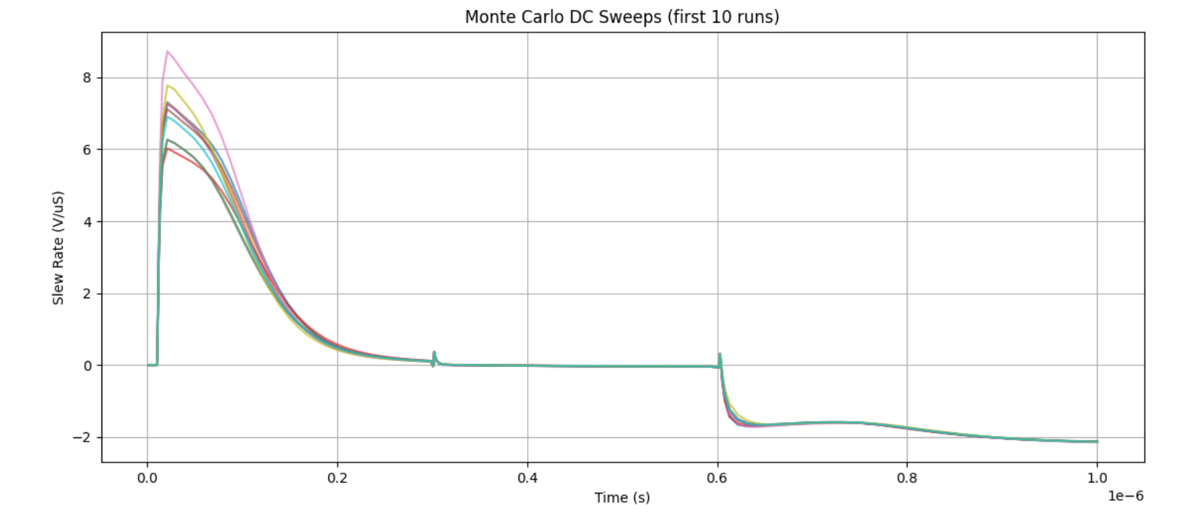
images/post_layout_sims/pl_mc_sr_fs.png
