PravinduG/sky130_op_amp/images/schematic_level_sims/mc_ac_phase_tt.png

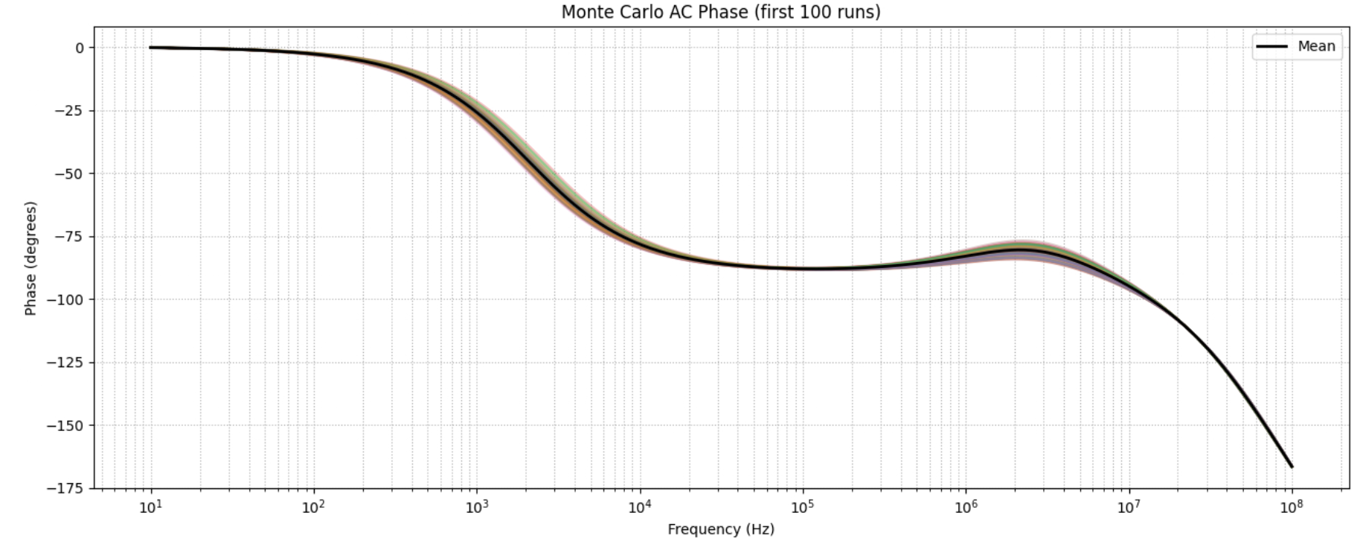
images/schematic_level_sims/mc_ac_phase_tt.png
