PravinduG/sky130_op_amp/images/schematic_level_sims/mc_sr_corner_ff.png

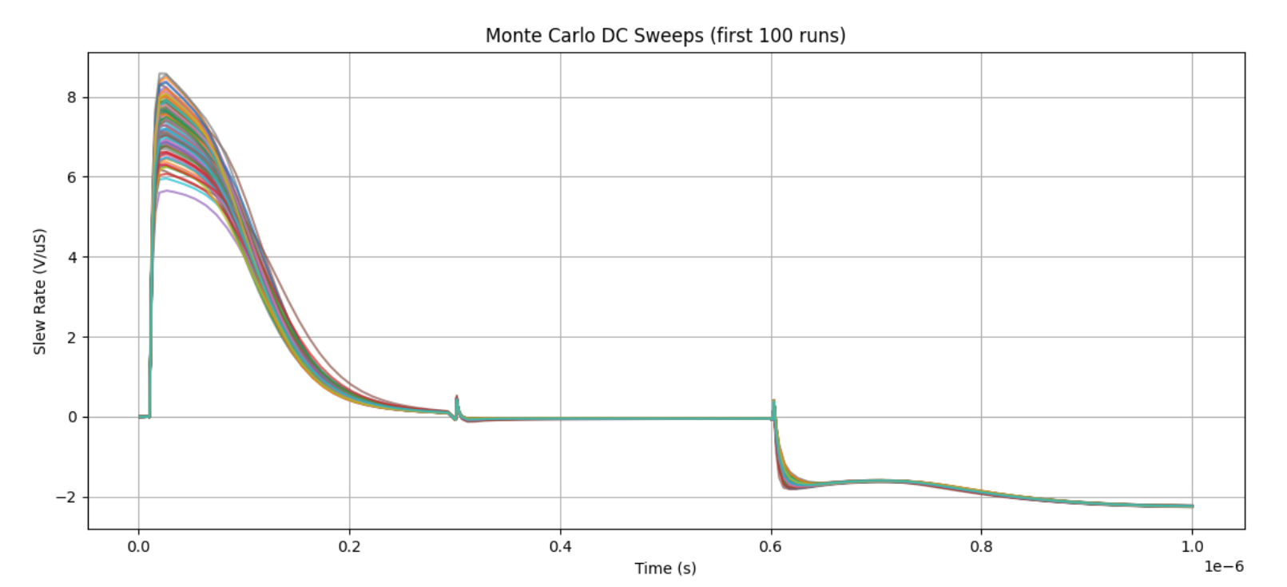
images/schematic_level_sims/mc_sr_corner_ff.png
