PravinduG/sky130_op_amp/images/schematic_level_sims/op_amp_schematic.png

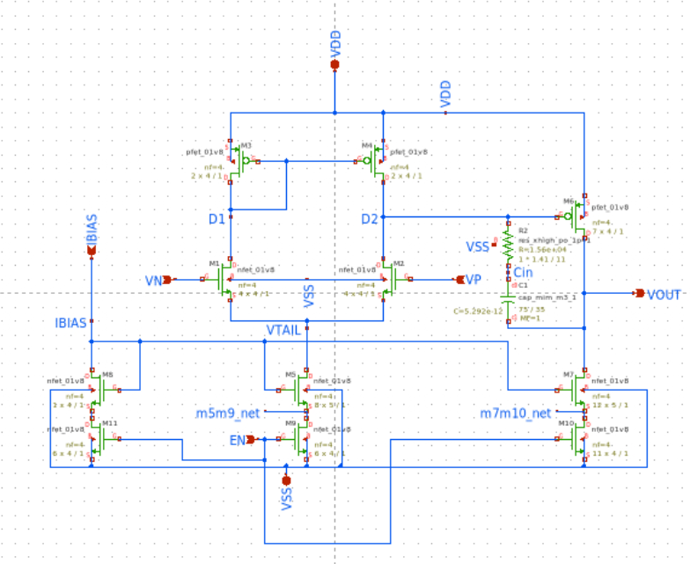
images/schematic_level_sims/op_amp_schematic.png
