PravinduG/sky130_op_amp/runs/RUN_2025-10-22_17-32-15/parameters/dc_params/gain_vs_temperature.png

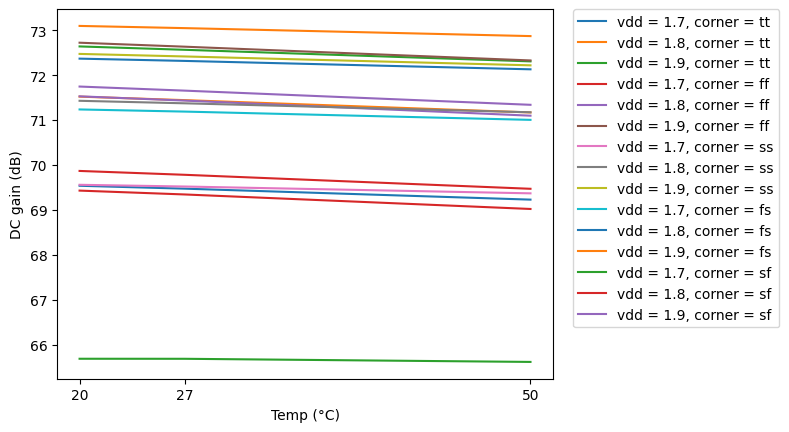
runs/RUN_2025-10-22_17-32-15/parameters/dc_params/gain_vs_temperature.png
