PravinduG/sky130_op_amp/runs/RUN_2025-10-22_17-32-15/parameters/dc_params/phase_margin_vs_corner.png

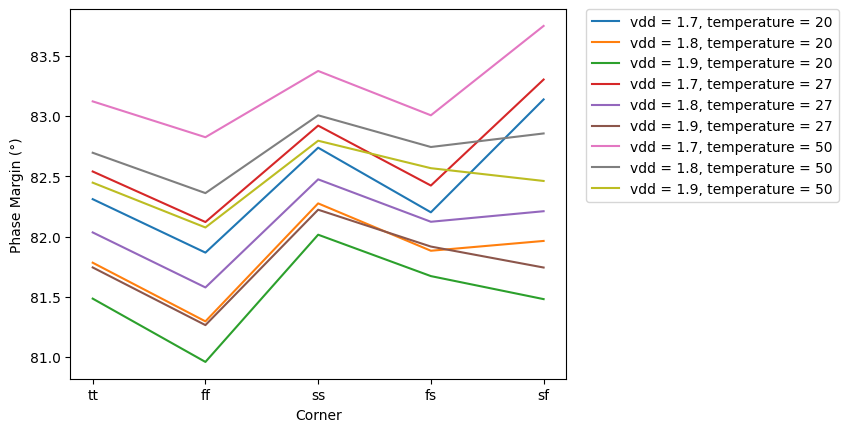
runs/RUN_2025-10-22_17-32-15/parameters/dc_params/phase_margin_vs_corner.png
