PravinduG/sky130_op_amp/images/schematic_level_sims/open_loop_step_tt.png

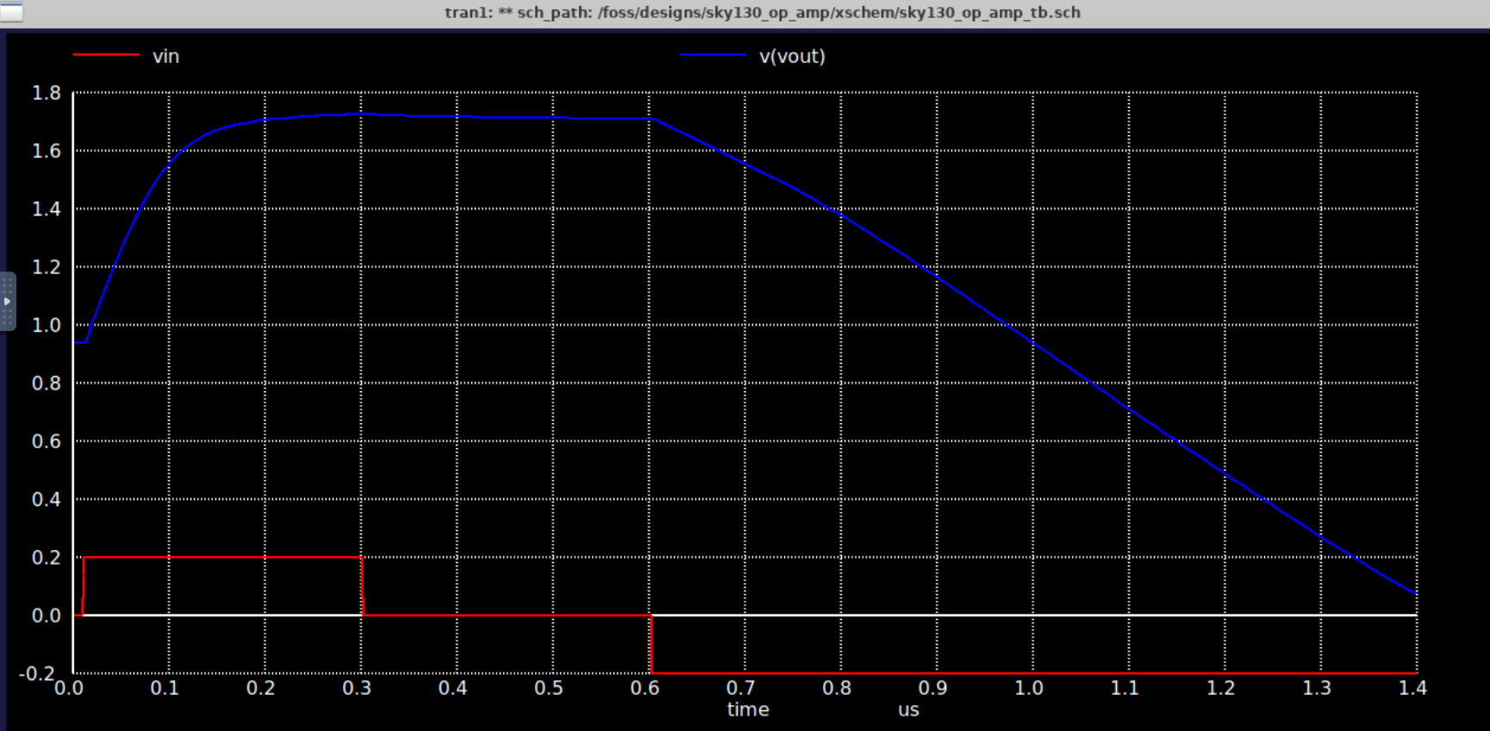
images/schematic_level_sims/open_loop_step_tt.png
