PravinduG/sky130_op_amp/images/schematic_level_sims/op_amp_testbench.png

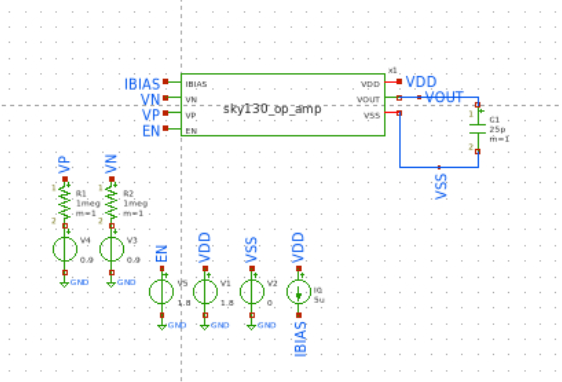
images/schematic_level_sims/op_amp_testbench.png
