PravinduG/sky130_op_amp/cace/sky130_op_amp.yaml

#--------------------------------------------------------------
# CACE circuit characterization file
#--------------------------------------------------------------

name:           sky130_op_amp
description:    2 stage operational amplifier design
PDK:            sky130A

cace_format:    5.2

authorship:
  designer:         Pravindu Goonetilleke x Nilakna Warushavithana
  company:          University of Moratuwa
  creation_date:    October 21, 2025
  license:          Apache 2.0

paths:
  root:             ..
  schematic:        xschem
  magic:            mag
  layout:           gds
  netlist:          netlist
  documentation:    docs

pins:
  VDD:
    description: Positive analog power supply
    type: power
    direction: inout
    Vmin: 1.7
    Vmax: 1.9
  VSS:
    description: Analog ground
    type: ground
    direction: inout
  IBIAS:
    description: Bias current input
    type: signal
    direction: input
  Vp:
    description: Voltage positive input
    type: signal
    direction: input
  Vn:
    description: Voltage negative input
    type: signal
    direction: input
  Vout:
    description: Voltage output
    type: signal
    direction: output
  En:
    description: Enable pin
    type: signal
    direction: input

default_conditions:
  vdd:
    description: Analog power supply voltage
    display: Vdd
    unit: V
    typical: 1.8
  vcm:
    description: Input common mode voltage
    display: Vcm
    unit: V
    typical: 0.9
  ib:
    description: Bias current
    display: Ib
    unit: uA
    typical: 5
  cl:
    description: Output load capacitance
    display: CLoad
    unit: pF
    maximum: 25
  corner:
    description: Process corner
    display: Corner
    typical: tt
  temperature:
    description: Ambient temperature
    display: Temp
    unit: °C
    typical: 27
      
parameters:
  dc_params:
    spec:
      a0:
        display: DC gain
        description: The DC gain of the OTA
        unit: dB
        minimum: 
          value: 60
        typical:
          value: any
        maximum:
          value: any
      ugf:
        display: Unity Gain Frequency
        description: The unity gain frequency of the OTA
        unit: Hz
        minimum:
          value: 1e6
        typical:
          value: any
        maximum:
          value: any
      pm:
        display: Phase Margin
        description: The phase margin of the OTA
        unit: °
        minimum: 
          value: 60
        typical:
          value: any
        maximum:
          value: any
    tool:
      ngspice:
        template: sky130_op_amp_tb.sch
        format: ascii
        suffix: .data
        variables: [a0, ugf, pm]
    plot:
      gain_vs_temperature:
        type: xyplot
        xaxis: temperature
        yaxis: a0
      phase_margin_vs_corner:
        type: xyplot
        xaxis: corner
        yaxis: pm
    conditions:
      vdd:
        minimum: 1.7
        typical: 1.8
        maximum: 1.9
      corner:
        enumerate: [tt, ff, ss, fs, sf] # fs, sf
      temperature:
        minimum: 20
        typical: 27
        maximum: 50


  magic_area:
    spec:
      area:
        display: Area
        description: Total circuit layout area
        unit: µm²
        maximum:
          value: 11200
      width:
        display: Width
        description: Total circuit layout width
        unit: µm
        maximum:
          value: 140
      height:
        display: Height
        description: Total circuit layout height
        unit: µm
        maximum:
          value: 80
    tool:
      magic_area

  magic_drc:
    description: Magic DRC
    display: Magic DRC
    spec:
      drc_errors:
        maximum:
          value: 0
    tool:
      magic_drc:
        gds_flatten: true

  netgen_lvs:
    description: Netgen LVS
    display: Netgen LVS
    spec:
      lvs_errors:
        maximum:
          value: 0
    tool:
      netgen_lvs

  klayout_drc_feol:
    description: KLayout DRC feol
    display: KLayout DRC feol
    spec:
      drc_errors:
        maximum:
          value: 0
    tool:
        klayout_drc:
            jobs: max
            args: ['-rd', 'feol=true']

  klayout_drc_beol:
    description: KLayout DRC beol
    display: KLayout DRC beol
    spec:
      drc_errors:
        maximum:
          value: 0
    tool:
        klayout_drc:
            jobs: max
            args: ['-rd', 'beol=true']

  klayout_drc_full:
    description: KLayout DRC full
    display: KLayout DRC full
    spec:
      drc_errors:
        maximum:
          value: 0
    tool:
        klayout_drc:
            jobs: max
            args: ['-rd', 'feol=true', '-rd', 'beol=true', '-rd', 'offgrid=true']

  magic_antenna_check:
    description: Run antenna violation check using magic
    display: Antenna Checks
    spec:
      antenna_violations:
        maximum:
          value: 0
    tool:
        magic_antenna_check
