PravinduG/sky130_op_amp/(commit log)

2025-10-21 Commit files + cace
    [sky130_op_amp.sch, sky130_op_amp_tb.sch]
2025-10-21 Add mc run
    [transient.sch]
2025-10-21 Add runs
    [ac.sch, simulation_summary.csv, sky130_op_amp_tb.sch, transient.sch]
2025-10-21 Runs edit
    [ac.sch, simulation_summary.csv, sky130_op_amp_tb.sch, transient.sch]
2025-10-22 Updated CACE, sch and tb
    [simulation_summary.csv, sky130_op_amp.sch, sky130_op_amp_tb.sch]
2025-10-22 cace + sch update
    [simulation_summary.csv, sky130_op_amp.sch, sky130_op_amp_tb.sch]
2025-10-22 undo sch change + cace update
    [simulation_summary.csv, sky130_op_amp.sch, sky130_op_amp_tb.sch]
2025-10-22 area updated in cace yaml
    [simulation_summary.csv, sky130_op_amp_tb.sch]
2025-10-22 update readme
    Updated the template for a 2-stage operational amplifier design, including changes to authorship, pins, default conditions, and associated images.
2025-10-22 Update schematic link in README.md
